HandHeldLegend/ProGCC-V3-Plus/PCB/production/ProGCC+ PCB Notes.xlsx

Sheet: Main PCB
# | Reference | Qty | Value | Footprint | DNP | MPN
1 | C1, C2, C4, C15, C17, C23, C24 | 7 | 100n | Capacitor_SMD:C_0201_0603Metric
2 | C3 | 1 | 10uF/10V (20%) | Capacitor_SMD:C_0603_1608Metric
3 | C5, C6, C7, C14 | 4 | 100nF | Capacitor_SMD:C_0603_1608Metric
4 | C8, C26, C28 | 3 | 1u | Capacitor_SMD:C_0201_0603Metric
5 | C9, C10, C11, C12 | 4 | .047u | Capacitor_SMD:C_0603_1608Metric_Pad1.08x0.95mm_HandSolder
6 | C13, C18, C21, C22 | 4 | 100n | Capacitor_SMD:C_0402_1005Metric
7 | C16 | 1 | 47uF 6.3v | Capacitor_Tantalum_SMD:CP_EIA-3216-18_Kemet-A
8 | C19 | 1 | 1u | Capacitor_SMD:C_0402_1005Metric
9 | C20, C25 | 2 | 10uF | Capacitor_SMD:C_0805_2012Metric
10 | C27 | 1 | 10uF | Capacitor_SMD:C_0402_1005Metric
11 | D1 | 1 | M7C | Diode_SMD:D_SOD-123 |  | B5819W SL
12 | D2, D3, D4, D5 | 4 | CUS08F30 | Diode_SMD:D_SOD-323_HandSoldering |  | CUS08F30
13 | F1, F2 | 2 | Fuse | Fuse:Fuse_1206_3216Metric_Pad1.42x1.75mm_HandSolder
14 | J1 | 1 | Conn_01x04_Pin | Connector_PinHeader_2.00mm:PinHeader_1x04_P2.00mm_Vertical |  | DNP
15 | J3 | 1 | To Button Board | progcc_v3:molex_5051101492_14P |  | molex_5051101492_14P
16 | J9 | 1 | USB_C_Receptacle | progcc_v3:Shou Han Type-C 24P QCHT |  | Shou Han Type-C 24P QCHT
17 | L1, L2, L3, L4, L5, L6, L7, L8 | 8 | SK6805-EC-15 | hhl:SK6805-EC-15 |  | SK6805-EC-15
18 | L9 | 1 | 1.3A 2.2uH ±20% 80mΩ | Inductor_SMD:L_1008_2520Metric |  | MIP25202R2MBE
19 | Q1 | 1 | Q_PMOS_GDS | Package_TO_SOT_SMD:SOT-23 |  | AO3401A
20 | Q2, Q3 | 2 | Q_NMOS_GSD | Package_TO_SOT_SMD:SOT-23 |  | AO3400A
21 | Q4, Q5 | 2 | BSS138DW | Package_TO_SOT_SMD:SOT-363_SC-70-6 |  | BSS138DW-7-F
22 | Q7, Q8 | 2 | MMBT3904 | Package_TO_SOT_SMD:SOT-23 |  | MMBT3904
23 | R1, R3, R5, R21, R24, R25, R26, R31, R32, R33 | 10 | 10k | Resistor_SMD:R_0201_0603Metric
24 | R2, R4 | 2 | 100R | Resistor_SMD:R_0201_0603Metric
25 | R6, R7, R10, R11, R12, R13, R14, R15, R16, R17, R18, R19, R20, R23 | 14 | 1k | Resistor_SMD:R_0201_0603Metric
26 | R8, R9 | 2 | 5.1k | Resistor_SMD:R_0201_0603Metric
27 | R22 | 1 | 330 | Resistor_SMD:R_0402_1005Metric
28 | R27, R28 | 2 | 0 | Resistor_SMD:R_0201_0603Metric
29 | R29, R30 | 2 | 27 | Resistor_SMD:R_0201_0603Metric
30 | R34, R35 | 2 | 75k | Resistor_SMD:R_0603_1608Metric
31 | R36 | 1 | 100 | Resistor_SMD:R_0201_0603Metric
32 | SW1, SW2 | 2 | GL18_SW | progcc_v3:GL18 |  | GL18
33 | SW3, SW5 | 2 | 1TS026A-1000-0550 | hhl:1TS026A-1000-0550 |  | 1TS026A-1000-0550
34 | SW4 | 1 | TS35CA | progcc_v3:TS35CA |  | TS35CA
35 | U1, U2, U3, U4 | 4 | GH39F (Hall SOT23) | progcc_v3:GH39F |  | GH39F
36 | U5, U11 | 2 | ST_LSM6 | hhl:LGA14 |  | LSM6DSRTR
37 | U6 | 1 | RP2040 | Package_DFN_QFN:QFN-56-1EP_7x7mm_P0.4mm_EP3.2x3.2mm |  | RP2040
38 | U7 | 1 | CH340K | hhl:ESSOP-10 |  | CH340K
39 | U8, U10 | 2 | MCP3002 | Package_SO:MSOP-8_3x3mm_P0.65mm |  | MCP3002-I/MS
40 | U9 | 1 | ESP32-PICO-MINI-02 | hhl:MODULE_ESP32-PICO-MINI-02 |  | ESP32-PICO-MINI-02
41 | U12 | 1 | PI3USB4000A | Package_DFN_QFN:Texas_UQFN-10_1.5x2mm_P0.5mm |  | PI3USB4000AZUAEX
42 | U13 | 1 | GD25Q80EEIGR | hhl:USON-8-EP(2x3) |  | GD25Q80EEIGR
43 | U14 | 1 | TPS630001RCR | hhl:VREG_V62_16624-01YE |  | TPS63001DRCR
44 | U16 | 1 | BQ25180 | hhl:DSBGA |  | BQ25180
45 | Y1 | 1 | Crystal_GND3 | Crystal:Resonator_SMD_Murata_CSTxExxV-3Pin_3.0x1.1mm |  | CSTNE12M0GH5L000R0

Sheet: Battery PCB
# | Reference | Qty | Value | Footprint | DNP | MPN
1 | U1 | 1 | 1982633-1 TE Connectivity | hhl:1982633-1 |  | 1982633-1

Sheet: Button PCB
# | Reference | Qty | Value | Footprint | DNP | MPN
1 | D1, D2, D3, D4, D5, D6 | 6 | BAS16VY,115 | Package_TO_SOT_SMD:SOT-363_SC-70-6
2 | J1 | 1 | To Button Board | progcc_v3:molex_5051101492_14P |  | 5051101492_14P
3 | J2 | 1 | bumpers | progcc_v3:molex_5034800540 |  | molex_5034800540
4 | L1, L2, L3, L4, L5, L6, L7, L8, L9, L10, L11, L12 | 12 | SK6805-EC-15 | hhl:SK6805-EC-15
5 | SW1, SW2, SW3, SW4 | 4 | TL3315NF100Q | hhl:PTS540JM035SMTRLFS |  | PTS540JM035SMTRLFS

Sheet: PCB Notes
PCB | Main | Button Board | Battery PCB
Thickness | 1.2mm | 0.8mm | 1.2mm
Finish | HASL | ENIG | HASL
Layers | 4 | 4 | 2
PCB Color | White | White | Any
Text Color | Black | Black | Any
Qty per Kit | 1 | 1 | 1
Included Accessories | LiPo Battery | Rumble Motor | 2x4 wires
Notes | CTR-003 Battery Pack for Nintendo Switch Pro Controller | 2x included and pre-soldered per kit. 3mm thick x 10mm | Pre-soldered Main PCB to Battery PCB. 5cm length.

Sheet: Battery PCB wiring diagram
Use orientation shown below for assembly guidelines

Sheet: LED Placement
SK6805-EC-15
