HandHeldLegend/ProGCC-V3-Plus/PCB/production/main_3S/progcc_3S_main.csv

# | Reference | Qty | MPN | Description | Value | Link | LCSC | Footprint | DNP
1 | J2 | 1 | 5051101492 | Flip type -40℃~+105℃ 14P Bottom Contact Horizontal attachment 0.5mm SMD,P=0.5mm,Surface Mount | To Button Board |  | C3169593 | progcc_v3:molex_5051101492_14P
2 | SW4 | 1 | 1TS026A-1000-0550 | 100gf 1.6mm 0.55mm Round Button Standing paste SPST SMD | 1TS026A-1000-0550 |  | C913778 | hhl:1TS026A-1000-0550
3 | Y1 | 1 | ABM8-272-T3 | 12MHz SMD3225-4P Crystals ROHS | ABM8-272-T3 |  | C20625731 | Crystal:Crystal_SMD_3225-4Pin_3.2x2.5mm
4 | L14 | 1 | AOTA-B201610S3R3-101-T | 0806 POLARIZED Fixed Inductors RoHS | 3.3u |  | C42411119 | hhl:L_pol_2016
5 | D1,D2,D3,D4,D5,D6 | 6 | B5819WT | 40V Independent Type 1A 550mV SOD-523 Schottky Diodes ROHS | M7C |  | C5364321 | Diode_SMD:D_SOD-523
6 | Q3,Q4 | 2 | BSS138DW-7-F | 50V 200mA 200mW 3.5Ω@10V,220mA 1.5V@250uA 2 N-Channel SC-70-6(SOT-363) MOSFETs ROHS | BSS138DW |  | C154900 | Package_TO_SOT_SMD:SOT-363_SC-70-6
7 | C19,C20 | 2 | CC0402FRNPO9BN150 | 50V 15pF NP0 ±1% | 15pF |  | C326803 | Capacitor_SMD:C_0402_1005Metric
8 | C9 | 1 | CC0603JRX7R9BB473 | 47uF 6.3V 1.6Ω@100kHz ±10% | 47uF |  | C7190 | Capacitor_Tantalum_SMD:CP_EIA-3216-18_Kemet-A
9 | C1,C2,C13,C14,C15,C16,C17 | 7 | CL03A104KQ3NNNC | 6.3V 100nF X5R ±10% | 100nF |  | C160831 | Capacitor_SMD:C_0201_0603Metric
10 | C21,C22,C24,C25 | 4 | CL05A475KP5NRNC | 10V 4.7uF X5R ±10% 0402 Ceramic Capacitors RoHS | 4.7u |  | C368809 | Capacitor_SMD:C_0402_1005Metric
11 | C12,C18 | 2 | CL21A106KPFNNNE | 10V 10uF X5R ±10% | 10uF |  | C17024 | Capacitor_SMD:C_0805_2012Metric
12 | D7,D8,D9 | 3 | CUS08F30,H3F | SOD-323 Schottky Diodes ROHS (TOSHIBA) | CUS08F30,H3F |  | C150183 | Diode_SMD:D_SOD-323_HandSoldering
13 | SW1,SW2 | 2 | GL1807SYAE-002 | TMR Analog Stick with button | GL1807SYAE-002 |  |  | hhl:GL1807SYAE
14 | C3,C4,C5,C6 | 4 | GRM033R60J105KEA2D | 6.3V 1uF X5R ±10% | 1uF |  | C76929 | Capacitor_SMD:C_0201_0603Metric
15 | C23,C26,C27,C28,C29,C30,C31,C32,C33,C34,C35 | 11 | GRM033R61A104KE15D | 10V 100nF X5R ±10% 0201 Ceramic Capacitors RoHS | 100n |  | C76934 | Capacitor_SMD:C_0201_0603Metric
16 | U4,U5 | 2 | LSM6DSRTR | Accelerometer gyroscope LGA-14(2.5x3) Accelerometers ROHS | ST_LSM6 |  | C784817 | hhl:LGA14
17 | L1 | 1 | MIP25202R2MBE | 1.3A 2.2uH ±20% 80mΩ 1008 Inductors (SMD) ROHS | 1.3A 2.2uH ±20% 80mΩ |  | C315721 | Inductor_SMD:L_1008_2520Metric
18 | Q1,Q2 | 2 | MMBT2222A | 600mA Ic, 40V Vce, NPN Transistor, SOT-23 | MMBT2222A |  | C916372 | Package_TO_SOT_SMD:SOT-23
19 | R11,R12 | 2 | RC0201FR-070RL | 0mW Thick Film Resistors 25V ±1% 0Ω | 0R |  | C106227 | Resistor_SMD:R_0201_0603Metric
20 | R15,R16,R17,R18,R19,R20,R21,R22,R23,R24,R27 | 11 | RC0201FR-071KL | 50mW Thick Film Resistors 25V ±1% ±200ppm/℃ 1kΩ | 1k |  | C138165 | Resistor_SMD:R_0201_0603Metric
21 | R3,R4 | 2 | RC0201FR-0710KL | 50mW Thick Film Resistors 25V ±1% ±200ppm/℃ 10kΩ | 10k |  | C106225 | Resistor_SMD:R_0201_0603Metric
22 | R29,R30 | 2 | RC0201FR-0727RL | 50mW Thick Film Resistors 25V ±1% ±200ppm/℃ 27Ω | 27R |  | C273268 | Resistor_SMD:R_0201_0603Metric
23 | R28 | 1 | RC0201FR-0733RL | Resistor | 33 |  | C295794 | Resistor_SMD:R_0201_0603Metric
24 | R9,R10,R25,R31 | 4 | RC0201FR-07100RL | 50mW Thick Film Resistors 25V ±1% ±200ppm/℃ 100Ω | 100R |  | C77623 | Resistor_SMD:R_0201_0603Metric
25 | R5,R6,R7,R8,R26 | 5 | RC0201FR-07330RL | 50mW Thick Film Resistors 25V ±1% ±200ppm/℃ 330Ω | 330R |  | C274872 | Resistor_SMD:R_0201_0603Metric
26 | R1,R2 | 2 | RC0201FR-075K1L | 50mW Thick Film Resistors 25V ±1% ±200ppm/℃ 5.1kΩ | 5.1k |  | C274341 | Resistor_SMD:R_0201_0603Metric
27 | U7 | 1 | RP2354A | QFN-60(7x7) Microcontrollers RoHS | RP2350_60QFN |  | C41378174 | hhl:RP2350-QFN-60-1EP_7x7_P0.4mm_EP3.4x3.4mm_ThermalVias
28 | L2,L3,L4,L5,L6,L7,L8,L9,L10,L11,L12,L13 | 12 | SK6805-EC-10 | RGB LED | SK6805-EC-10 | https://cdn-shop.adafruit.com/product-files/5849/SK6805-EC10-000_REV.01_EN.pdf |  | hhl:SK6805-EC-10
29 | J4,J5 | 2 | SM02B-SURS-TF(LF)(SN) | Connector Header Surface Mount, Right Angle 2 position 0.031 (0.80mm) | SM02B-SURS-TF_LF__SN_ |  | C566239 | hhl:JST_SM02B-SURS-TF_LF__SN_
30 | C7,C8,C10,C11 | 4 | TAJA476K006RNJ | 50V 47nF X7R ±5% 0603 | 47nF |  | C519554 | Capacitor_SMD:C_0603_1608Metric
31 | U6 | 1 | TPS63001DRCR | High efficiency Buck-Boost Converter with 1.8A Current Switches in 3x3 QFN | TPS63001DRCR |  | C28060 | hhl:VREG_V62_16624-01YE
32 | SW3 | 1 | TS35CA | 3.4mm 3.3mm Round Button Horizontal attachment SPST SMD | TS35CA |  | C412366 | hhl:TS35CA
33 | J1 | 1 | USB4056-03-A | USB Connectors USB C 3.2 Rec, Horz, Hybrid PCB Top Mount, T+R | USB4056-03-A |  | C7407280 | hhl:USB405603A
34 | U1,U2,U3 | 3 | USBLC6-2P6 | Very low capacitance ESD protection diode, 2 data-line, SOT-666 | USBLC6-2P6 |  | C2827693 | Package_TO_SOT_SMD:SOT-666
