HandHeldLegend/ProGCC-V3-Plus/PCB/production/main_3.1/ProGCC 3.1 PCB Notes.xlsx

Sheet: OverView
The ProGCC 3.1 PCB can be assembled in a manner which would include or exclude wireless function. See the 'BT Version Main PCB' for BOM. Also, see the Wired Version Main PCB BOM. Each are meant for the same PCB but include different parts. This allows for a more efficient production cost as we can produce many of the same PCB for different products. | Last Updated 7/13/2024

Sheet: Main PCB BOM
Reference | Value | Datasheet | Footprint | MPN | Qty | DNP | Include Components on Bluetooth Version | BT DNP | Include Components on Wired Version | WIRED DNP
C1,C17,C23,C32 | 100n | ~ | Capacitor_SMD:C_0201_0603Metric |  | 4 |  | TRUE |  | TRUE
C2,C4,C15,C24 | 100n | ~ | Capacitor_SMD:C_0201_0603Metric |  | 4 |  | TRUE |  | FALSE | YES
C3 | 10uF/10V (20%) | ~ | Capacitor_SMD:C_0603_1608Metric |  | 1 |  | TRUE |  | FALSE | YES
C5,C6,C7,C14 | 100nF | ~ | Capacitor_SMD:C_0603_1608Metric |  | 4 |  | TRUE |  | TRUE
C8,C26,C28 | 1u | ~ | Capacitor_SMD:C_0201_0603Metric |  | 3 |  | TRUE |  | FALSE | YES
C9,C10,C11,C12 | .047u | ~ | Capacitor_SMD:C_0603_1608Metric_Pad1.08x0.95mm_HandSolder |  | 4 |  | TRUE |  | TRUE
C13,C18,C21,C22 | 100n | ~ | Capacitor_SMD:C_0402_1005Metric |  | 4 |  | TRUE |  | TRUE
C16 | 47uF 6.3v | ~ | Capacitor_Tantalum_SMD:CP_EIA-3216-18_Kemet-A |  | 1 |  | TRUE |  | TRUE
C19 | 1u | ~ | Capacitor_SMD:C_0402_1005Metric |  | 1 |  | TRUE |  | TRUE
C20,C25 | 10uF | ~ | Capacitor_SMD:C_0805_2012Metric |  | 2 |  | TRUE |  | TRUE
C27 | 10uF | ~ | Capacitor_SMD:C_0402_1005Metric |  | 1 |  | TRUE |  | FALSE | YES
C30,C31 | 1uF | ~ | Capacitor_SMD:C_0201_0603Metric |  | 2 |  | TRUE |  | TRUE
D1,D2,D3 | CUS08F30 | -- mixed values -- | Diode_SMD:D_SOD-323_HandSoldering | CUS08F30 | 3 |  | TRUE |  | TRUE
D4 | CUS08F30 |  | Diode_SMD:D_SOD-323_HandSoldering | CUS08F30 | 1 |  | TRUE |  | FALSE | YES
J1 | Conn_01x04_Pin | ~ | Connector_PinHeader_2.00mm:PinHeader_1x04_P2.00mm_Vertical |  | 1 |  | TRUE |  | TRUE
J2,J4 | SM02B-SURS-TF_LF__SN_ |  | hhl:JST_SM02B-SURS-TF_LF__SN_ | SM02B-SURS-TF(LF)(SN) | 2 |  | TRUE |  | TRUE
J3 | To Button Board | ~ | progcc_v3:molex_5051101492_14P | molex_5051101492_14P | 1 |  | TRUE |  | TRUE
J9 | USB_C_Receptacle | https://www.usb.org/sites/default/files/documents/usb_type-c.zip | progcc_v3:Shou Han Type-C 24P QCHT | Shou Han Type-C 24P QCHT | 1 |  | TRUE |  | TRUE
L1,L2,L3,L4,L5,L6,L7,L8,L10,L11,L12,L13 | SK6805-EC-10 | https://cdn-shop.adafruit.com/product-files/5849/SK6805-EC10-000_REV.01_EN.pdf | hhl:SK6805-EC-10 | SK6805-EC-15 | 12 |  | TRUE |  | TRUE
L9 | 1.3A 2.2uH ±20% 80mΩ | ~ | Inductor_SMD:L_1008_2520Metric | MIP25202R2MBE | 1 |  | TRUE |  | TRUE
Q4,Q5 | BSS138DW | https://datasheet.lcsc.com/lcsc/1912111437_Diodes-Incorporated-BSS138DW-7-F_C154900.pdf | Package_TO_SOT_SMD:SOT-363_SC-70-6 | BSS138DW-7-F | 2 |  | TRUE |  | TRUE
Q7,Q8 | MMBT3904 | https://www.onsemi.com/pdf/datasheet/pzt3904-d.pdf | Package_TO_SOT_SMD:SOT-23 | MMBT3904 | 2 |  | TRUE |  | FALSE | YES
R1,R2,R4,R38 | 0R | ~ | Resistor_SMD:R_0603_1608Metric_Pad0.98x0.95mm_HandSolder |  | 4 |  | FALSE | YES | TRUE
R3,R6,R7,R10,R11,R12,R13,R14,R15,R16,R17,R18,R19,R20,R23 | 1k | ~ | Resistor_SMD:R_0201_0603Metric |  | 15 |  | TRUE |  | TRUE
R5,R21 | 10k | ~ | Resistor_SMD:R_0201_0603Metric |  | 2 |  | TRUE |  | TRUE
R8,R9 | 5.1k | ~ | Resistor_SMD:R_0201_0603Metric |  | 2 |  | TRUE |  | TRUE
R22 | 330 | ~ | Resistor_SMD:R_0402_1005Metric |  | 1 |  | TRUE |  | FALSE
R24,R25,R26,R31,R32,R33 | 10k | ~ | Resistor_SMD:R_0201_0603Metric |  | 6 |  | TRUE |  | FALSE | YES
R27,R28 | 0 | ~ | Resistor_SMD:R_0201_0603Metric |  | 2 |  | TRUE |  | FALSE | YES
R29,R30 | 27 | ~ | Resistor_SMD:R_0201_0603Metric |  | 2 |  | TRUE |  | TRUE
R34,R35 | 75k | ~ | Resistor_SMD:R_0603_1608Metric |  | 2 |  | TRUE |  | FALSE | YES
R36 | 100 | ~ | Resistor_SMD:R_0201_0603Metric |  | 1 |  | TRUE |  | TRUE
R37 | 1.2k | ~ | Resistor_SMD:R_0201_0603Metric |  | 1 |  | TRUE |  | TRUE
SW1,SW2 | GL1807SYAE-002 | ${KIPRJMOD}/../progcc_v3_libs/docs/GuliKit Hall stick GL18,hall sensor datasheet.pdf | hhl:GL1807SYAE | GL1807SYAE-002 | 2 |  | TRUE |  | TRUE
SW3 | 1TS026A-1000-0550 | https://datasheet.lcsc.com/lcsc/2201131300_HYP--Hongyuan-Precision-1TS026A-1000-0550-CT_C913778.pdf | hhl:1TS026A-1000-0550 | 1TS026A-1000-0550 | 1 |  | TRUE |  | TRUE
SW4 | TS35CA | ${KIPRJMOD}/../progcc_v3_libs/docs/1912111437_SHOU-HAN-TS35CA_C412366.pdf | hhl:TS35CA | TS35CA | 1 |  | TRUE |  | TRUE
SW5 | 1TS026A-1000-0550 | https://datasheet.lcsc.com/lcsc/2201131300_HYP--Hongyuan-Precision-1TS026A-1000-0550-CT_C913778.pdf | hhl:1TS026A-1000-0550 | 1TS026A-1000-0550 | 1 |  | TRUE |  | FALSE | YES
U5,U11 | ST_LSM6 |  | hhl:LGA14 | LSM6DSRTR | 2 |  | TRUE |  | TRUE
U6 | RP2040 | ${KIPRJMOD}/../progcc_v3_libs/docs/rp2040-datasheet.pdf | Package_DFN_QFN:QFN-56-1EP_7x7mm_P0.4mm_EP3.2x3.2mm | RP2040 | 1 |  | TRUE |  | TRUE
U7 | CH340K | https://cdn.sparkfun.com/assets/5/0/a/8/5/CH340DS1.PDF | hhl:ESSOP-10 | CH340K | 1 |  | TRUE |  | FALSE | YES
U8,U10 | MCP3002 | http://ww1.microchip.com/downloads/en/DeviceDoc/21294E.pdf | Package_SO:MSOP-8_3x3mm_P0.65mm | MCP3002-I/MS | 2 |  | TRUE |  | TRUE
U9 | ESP32-PICO-MINI-02 |  | hhl:MODULE_ESP32-PICO-MINI-02 | ESP32-PICO-MINI-02 | 1 |  | TRUE |  | FALSE | YES
U12 | PI3USB4000A | https://datasheet.lcsc.com/lcsc/1811141855_Diodes-Incorporated-PI3USB4000AZUAEX_C294596.pdf | Package_DFN_QFN:Texas_UQFN-10_1.5x2mm_P0.5mm | PI3USB4000AZUAEX | 1 |  | TRUE |  | FALSE | YES
U13 | GD25Q80EEIGR | https://datasheet.lcsc.com/lcsc/2108150330_GigaDevice-Semicon-Beijing-GD25Q80EEIGR_C2874937.pdf | hhl:USON-8-EP(2x3) | GD25Q80EEIGR | 1 |  | TRUE |  | TRUE
U14 | TPS63001DRCR |  | hhl:VREG_V62_16624-01YE | TPS63001DRCR | 1 |  | TRUE |  | TRUE
U15 | DRV2605LYZFR | https://www.ti.com/lit/ds/symlink/drv2605l.pdf?ts=1704174329783 | Package_BGA:Texas_DSBGA-9_1.4715x1.4715mm_Layout3x3_P0.5mm | DRV2605LYZFR | 1 |  | TRUE |  | TRUE
U16 | BQ25180 | https://www.ti.com/lit/ds/symlink/bq21061.pdf | hhl:DSBGA | BQ25180 | 1 |  | TRUE |  | FALSE | YES
Y1 | Crystal_GND3 | ~ | Crystal:Resonator_SMD_Murata_CSTxExxV-3Pin_3.0x1.1mm | CSTNE12M0GH5L000R0 | 1 |  | TRUE |  | TRUE

Sheet: PCB Notes
PCB | Main
Thickness | 1.2mm
Finish | HASL
Layers | 4
PCB Color | White
Text Color | Black
Qty per Kit | 1

Sheet: Battery PCB wiring diagram
Use orientation shown below for assembly guidelines

Sheet: LED Orientation
SK6805-EC-10
