HandHeldLegend/ProGCC-V3-Plus/PCB/main_3.1/procon_gcc_main_pcb.pdf

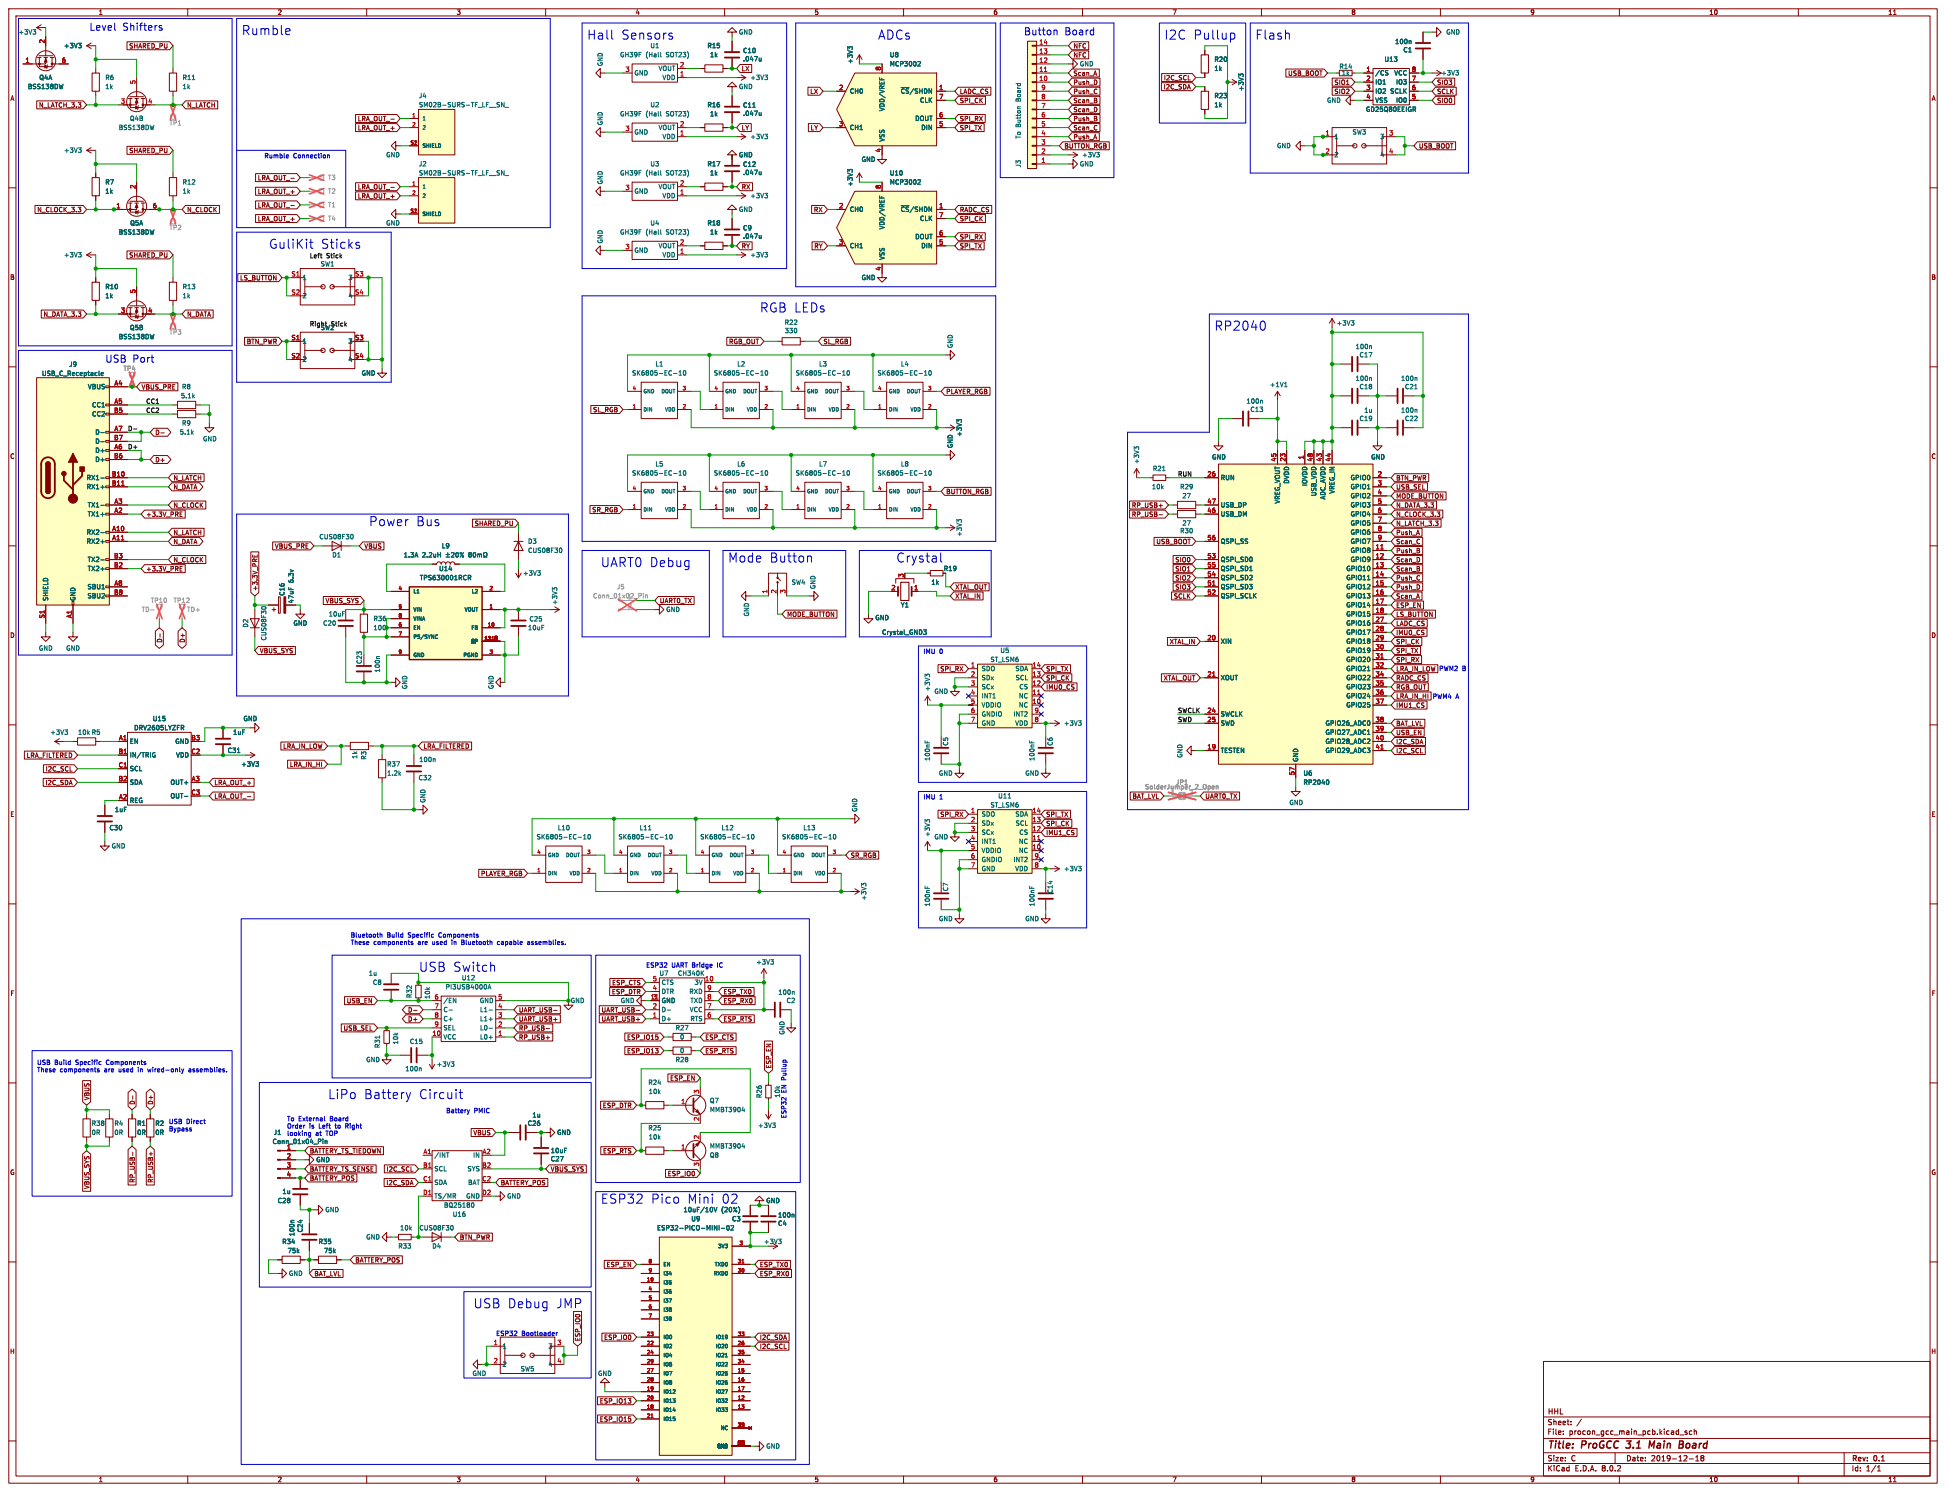
[picture p1: page 1]

4 DIN 5 DOUT 6 CLK 7 VDD/VREF
SPI_CK RADC_CS

Id: 1/1 Title: ProGCC 3.1 Main Board
