HandHeldLegend/ProGCC-V3-Plus/(commit log)

2023-09-01 Initial backup commit
    [procon_gcc_button_board-B_Courtyard.gbr, procon_gcc_button_board-B_Cu.gbr, procon_gcc_button_board-B_Fab.gbr, procon_gcc_button_board-B_Mask.gbr, procon_gcc_button_board-B_Paste.gbr, procon_gcc_button_board-B_Silkscreen.gbr, procon_gcc_button_board-Edge_Cuts.gbr, procon_gcc_button_board-F_Courtyard.gbr]
2023-09-02 Update PCB
    [procon_gcc_main_pcb.kicad_pcb, procon_gcc_main_pcb.kicad_sch]
2023-09-02 production update
    [ProGCC Plus BOM.xlsx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]
2023-09-02 Fix text size
    [procon_gcc_main_pcb-B_Courtyard.gbr, procon_gcc_main_pcb-B_Cu.gbr, procon_gcc_main_pcb-B_Fab.gbr, procon_gcc_main_pcb-B_Mask.gbr, procon_gcc_main_pcb-B_Paste.gbr, procon_gcc_main_pcb-B_Silkscreen.gbr, procon_gcc_main_pcb-Edge_Cuts.gbr, procon_gcc_main_pcb-F_Courtyard.gbr]
2023-09-02 Add battery level ADC reader
    [ProGCC Plus BOM.xlsx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]
2023-09-07 Change regulator
    [ProGCC Plus BOM.xlsx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]
2023-10-18 Fix PCB Issue + BT Update
    [procon_gcc_main_pcb.kicad_pcb, procon_gcc_main_pcb.kicad_sch]
2023-12-07 Update to new bt backend
    [procon_gcc_main_pcb.kicad_pcb]
2023-12-15 12.15.2023 update
    - Resolve Gyro in steam
2023-12-19 Major updates for BT Modes
    - Xinput mode fully working with rumble
    - New LED stuff
2023-12-20 Update regulator
    [procon_gcc_main_pcb.kicad_pcb, procon_gcc_main_pcb.kicad_sch]
2024-01-03 haptic test build
    [ProGCC+ PCB Notes (Haptic Version).xlsx, ProGCC+ PCB Notes.xlsx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]
2024-02-24 Update hardware layout etc.
    [procon_gcc_main_pcb.kicad_pcb, procon_gcc_main_pcb.kicad_sch]
2024-03-07 Update production files
    [ProGCC 3.1 Kit Notes.xlsx]
2024-03-08 Update BOM script and exported values
    [ProGCC 3.1 PCB Notes.xlsx, procon_gcc_main_pcb_bluetooth.csv, procon_gcc_main_pcb_usb.csv]
2024-03-29 Update RGB Library
    Update includes
    - Fix so now you can turn the controller on and keep the on button held until it's ready
    - Turn off controller by holding L3/R3 together.
2024-04-19 Frameperfect update
2024-05-01 4.30 Update
    Test new IMU mode
2024-05-01 5.1.2024 Update
    - Gyro Mode 0x02
    - Fix Rumble case not stopping vibrations
2024-05-14 PCB and FW Updates
    - Add player number support internally
    - Add debug for bt baseband updating
    - Orange indication for baseband update mode
    [procon_gcc_main_pcb.kicad_pcb, procon_gcc_main_pcb.kicad_sch]
2024-05-17 5.16.2024 update
    N64 Fixes
    [procon_gcc_main_pcb.kicad_pcb, procon_gcc_main_pcb.kicad_sch]
2024-06-05 LED Trigger update
    [procon_gcc_main_pcb.kicad_sch]
2024-06-05 Fix LED Player
2024-06-13 6.13 update
    - Update SNES mode power settings
2024-06-15 6.14.2024
    Fix trigger led mappings
2024-06-15 Changes for analog stick jitter
2024-06-23 Changes to remove debug code
    - Remove debug smoothing of value 16 (Should have been 4 on mainline)
    - Disable PMIC voltage regulation (Two switching regulators were stacking, adding noise to the voltage readings on the analog sticks)
    [procon_gcc_main_pcb.kicad_sch]
2024-06-25 6.25.2024 Update
    charging animation update
2024-06-29 Fix PCB Main
    - Move main ribbon connector left to avoid collision issue
    - Move ribbon connector to support new ribbon placement
    [procon_gcc_main_pcb-B_Courtyard.gbr, procon_gcc_main_pcb-B_Cu.gbr, procon_gcc_main_pcb-B_Fab.gbr, procon_gcc_main_pcb-B_Mask.gbr, procon_gcc_main_pcb-B_Paste.gbr, procon_gcc_main_pcb-B_Silkscreen.gbr, procon_gcc_main_pcb-Edge_Cuts.gbr, procon_gcc_main_pcb-F_Courtyard.gbr]
2024-06-29 update r2 label
    [procon_gcc_main_pcb-B_Courtyard.gbr, procon_gcc_main_pcb-B_Cu.gbr, procon_gcc_main_pcb-B_Fab.gbr, procon_gcc_main_pcb-B_Mask.gbr, procon_gcc_main_pcb-B_Paste.gbr, procon_gcc_main_pcb-B_Silkscreen.gbr, procon_gcc_main_pcb-Edge_Cuts.gbr, procon_gcc_main_pcb-F_Courtyard.gbr]
2024-07-06 PCB revision
    - Exchange G18 sticks for newer iteration with TMR sensing
    [ProGCC 3.1 PCB Notes.xlsx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]
2024-07-12 IMU Update
2024-07-14 PCB Update r2
    [ProGCC 3.1 PCB Notes.xlsx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]
2024-07-31 Fix BT haptics
    [ProGCC 3.2 Kit Notes.xlsx, ProGCC 3.2 PCB Notes.xlsx, progcc_3.2_BOM.csv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]
2024-08-03 Fix battery checking for wired
2024-08-05 I2C Comms Update
2024-09-01 Update 3.2 PCB
    [ProGCC 3.2 Kit Notes.xlsx, ProGCC 3.2 PCB Notes.xlsx, progcc_3.2_BOM.csv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]
2024-09-01 Add gerber zip
2024-09-11 Update battery charge status system
2024-09-24 Changes for battery
2024-10-26 Update PCB Files
    - Standardize differing resistor sizes
    - Update oscillator
    [progcc_3.2_main-B_Courtyard.gbr, progcc_3.2_main-B_Cu.gbr, progcc_3.2_main-B_Fab.gbr, progcc_3.2_main-B_Mask.gbr, progcc_3.2_main-B_Paste.gbr, progcc_3.2_main-B_Silkscreen.gbr, progcc_3.2_main-Edge_Cuts.gbr, progcc_3.2_main-F_Courtyard.gbr]
2024-10-26 Update PCB Zip
2024-10-29 Fix battery flashing fallback bug for wired 3.1/3.2
2024-11-21 Fix battery charging stopping #1
2024-11-25 PCB Fix BOM
    [ProGCC 3.2 BOM Wired and Wireless.xlsx, progcc_3.2_main.kicad_sch, progcc_3.2_main_all.csv]
2024-11-25 Add new XLXS and zip for PCB
    [BOM ProGCC 3.2 Wired and Wireless.xlsx, ProGCC 3.2 BOM Wired and Wireless.xlsx]
2025-01-13 PCB BOM update
    [BOM ProGCC 3.2 Wired and Wireless.xlsx, BOM ProGCC 3.2 Wired_Wireless.xlsx, progcc_3.2_main_all.csv]
2025-02-02 FW Move
    FW Moved to: https://github.com/HandHeldLegend/hoja-device-fw/tree/main/boards
2026-07-30 3S Resistor Update
